vignura/CZ-02-BluetoothControl/1V00/HW/Images/CARBTF1.JPG

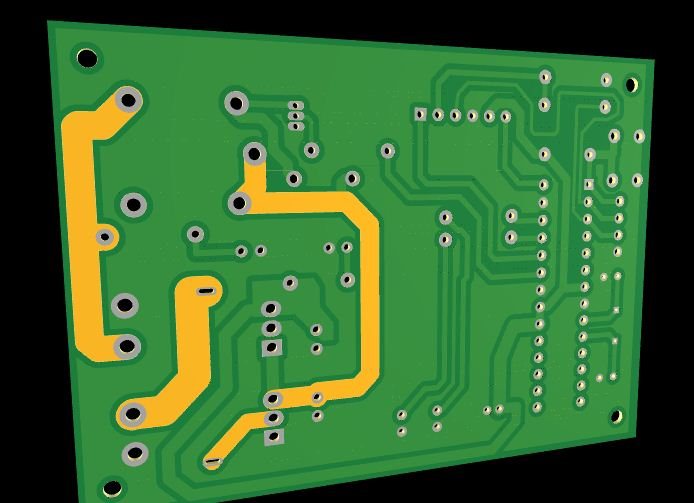
1V00/HW/Images/CARBTF1.JPG
