vignura/CZ-02-BluetoothControl/README.md

# CZ-02-BluetoothControl
bluetooth controller module

Note: This module uses Relay library that is available at below link.
https://github.com/vignura/Arduino/tree/master/libraries/Relay
