vignura/CZ-02-BluetoothControl/2V00/SW/Docs/PPT/Industrial Automation.odp

Bed Room Wiring

Switch 1

Fan

Switch 2

Night

Lamp

Tube

Light

Mains

(220V AC)

Switch 3

Switch 4

Terrace

Light

Switch 5

Light

Holder

Switch 6

3 Pin

Plug Point

## Slide 2

Start

Input 1

Input 1

Input 2

Input

Input 3

Input 1

Yes/No

Process

Yes/No

Yes/No

Yes/No

1.Input 1 = Limit sw 1(NO<COM) [High>Low] Relay 1 Off

2.Input 2 = Limit sw 1(NC<COM)[Low>High]Relay 2 On

3.Input 3 = Float sw 1(NC<COM)[High>Low]Relay 2 Off

4.Input 4 = Limit sw 2(NC<COM)[High>Low]Relay 2 Off

Stop

## Slide 3

Limit switch 1

-> GPIO X

Turn On Relay 1 if High

Turn Off Relay 1 if Low

## Slide 4

Bed Room Wiring

Type A

Switch 1

Fan

Switch 2

Night

Lamp

Relay Module

Tube

Light

Mains

(220V AC)

Switch 3

Switch 4

Terrace

Light

Switch 5

Light

Holder

Switch 6

3 Pin

Plug Point

## Slide 5

Bed Room Wiring

Type B

Switch 1

Fan

Switch 2

Night

Lamp

Relay Module

Tube

Light

Mains

(220V AC)

Bypass

Switch

Switch 3

Switch 4

Terrace

Light

Switch 5

Light

Holder

Switch 6

3 Pin

Plug Point

## Slide 6

## Slide 7

9.3 cm

2 cm

5.6 cm

## Slide 8

9.3 cm

2 cm

5.6 cm

## Slide 9

1.5 cm

9.2 cm

4.1 cm

## Slide 10

1.5 cm

9.2 cm

4.1 cm

## Slide 11

X

5.94 X

2.03 X

5.94 X

2.03 X
