vignura/CZ-02-BluetoothControl/2V00/SW/Docs/ICD/BluetoothController-ICD-1V01.odt

Interface Control Document

for

Bluetooth Controller Module

The Bluetooth Controller Module has the following commands,

1. Relay On with Time command
2. Relay Off command
3. Start Self Command

SNo | Command String | Description
1 | “RlyOn HH:MM:SS” | Turns on the Relay for time specified, (Timer) ON Time = ((HH * 3600) + (MM * 60) + SS) seconds
2 | “RlyOff” | Turns off the Relay
3 | “StTest” | Performs Self Test, in which, Usr_LED_1, Usr_LED_1 and Relay are turned on for 2 seconds and turned off.

Note:

Relay off command will turn relay off immedeately and stop any running timers.
