vignura/CZ-02-BluetoothControl/1V00/HW/BOM/BOM_CARBT_20181124124831.csv

ID | Name | Designator | Footprint | Quantity | Manufacturer Part | Manufacturer | Supplier | Supplier Part | Mounted
1 | ATMEGA328P-PU | U1 | DIP-28_300MIL | 1 | ATMEGA328P-PU | MICROCHIP | LCSC | C33901 | Yes
2 | L7805ABV | U2 | TO-220(TO-220-3) | 1 | L7805ABV | STMicroelectronics | LCSC | C16807 | Yes
3 | IRF9530NPBF | Q1 | TO-220(TO-220-3) | 1 | IRF9530NPBF | IR | LCSC | C2574 | Yes
4 | 1k | R1,R3 | AXIAL-0.3 | 2 | ? |  |  |  | Yes
5 | 49S | X1 | HC-49S | 1 | 49S DIP Crystal insulation film | YXC | LCSC | C35018 | Yes
6 | 22pF | C1,C3 | RAD-0.1 | 2 | 22pf/50V 10% | ReliaPro | LCSC | C9316 | Yes
7 | 2N3904 | Q2 | TO-92(TO-92-3) | 1 | 2N3904 | SEMTECH | LCSC | C118538 | Yes
8 | 1k | R2,R5,R7,R8 | AXIAL-0.4 | 4 | ? |  |  |  | Yes
9 | 1N4448 | D1 | DO-35 | 1 | 1N4448 | SEMTECH | LCSC | C54037 | Yes
10 | SRD-03VDC-SL-C | RELAY1 | RELAY-SL-SRD | 1 | SRD-03VDC-SL-C | SONGLE | LCSC | C24585 | Yes
11 | WJ2EDGVC-5.08-2P | P1,P3 | WJ2EDGVC-5.08-2P | 2 | WJ2EDGVC-5.08-2P | ReliaPro | LCSC | C8445 | Yes
12 | LEDOrange orange 3AO4UD | LED1,LED2,LED3,LED4 | LED-3MM | 4 | LEDOrange orange 3AO4UD | KENTO | LCSC | C62095 | Yes
13 | 47uF | C2,C4 | CAP-D6.3XF2.5 | 2 | Aluminum electrolytic capacitors47uF 63V 20% High frequency green gold | ValuePro | LCSC | C60712 | Yes
14 | 4.7k | R4 | AXIAL-0.4 | 1 | ? |  |  |  | Yes
15 | 10uF | C5 | CAP-D5.0XF2.0 | 1 | electrolytic capacitor 10UF 50V high frequency | ValuePro | LCSC | C78759 | Yes
16 | Header-Female-2.54_1x6 | P2 | HDR-6X1/2.54 | 1 | Female header 1*6p | BOOMELE | LCSC | C40877 | Yes
17 | 2.2K | R6 | AXIAL-0.4 | 1 | ? |  |  |  | Yes
18 | Header-Male-2.54_1x4 | H1 | 210S-1X4P | 1 | 210S-1*4P L=11.6MMGold-plated black | Ckmtw | LCSC | C124378 | Yes
19 | 5x20 BLX-Atype Fuse holder XC-7 | F1 | 5X20-BLX-A | 1 | 5x20 BLX-Atype Fuse holder XC-7 | XCFuse | LCSC | C3131 | Yes
20 | TS-1102-5016 | KEY1 | KEY-6.0*6.0-2 | 1 | TS-1102-5016 | SOFNG | LCSC | C111609 | Yes
