vignura/CZ-02-BluetoothControl/Plan/PCB-Production-Plan.ods

Sheet: Production
Component | Qty | Points / Component | Total points
Resistors | 7 | 2 | 14
Capacitor Disc | 3 | 2 | 6
Capacitor Electorlytic | 3 | 2 | 6
LED | 2 | 2 | 4
Crystal | 1 | 2 | 2
Diode | 2 | 2 | 4
Regulator (7805) | 1 | 3 | 3
Transistor | 1 | 3 | 3
Relay | 1 | 4 | 4
Fuse holder | 1 | 2 | 2
Reset button | 1 | 4 | 4
Screw Connector | 3 | 2 | 6
Female Bug strip 6 pin | 1 | 6 | 6
IC base | 1 | 28 | 28
Jumper | 3 | 2 | 6
 |  | Total points | 98
Time Per point | 25 | s
Total time per board | 2450 | s
 | 40.83 | mins
Total boards | 200
Total time | 490000 | s
 | 136.11 | Hrs
Hours per day | 5 | Hrs
Time in days | 27.222 | days
Persons | 2.5
Time in days | 10.8888

Sheet: Programming & Testing
No of Borads | 200 |  | Testing
 |  |  | Bluetooth App Setup time | 300 | s
 |  |  | Bluetooth Unpair and repair | 180 | s
Boot Loader Lodaing
Setup time | 1800 | s | Tests
Load Time | 30 | s | On test | 5
Total time | 6000 | s | Off | 5
 | 100 | mins | On 5 sec | 10
No of sessions | 4 |  | Self Test | 5
Session time | 25 | mins | Emergency Stop | 5
Seesion break | 5 | mins
 |  |  | Test Time / board | 210 | s
Total time | 150 | mins | Total time | 42300 | s
 |  |  |  | 11.75 | Hrs
Code Loading
Setup time | 5 | mins | No of persons | 1
Load Time | 30 | s | Hours / day | 3
Total time | 6000 | s | No of days | 3.9166666667 | days
 | 100 | mins
No of sessions | 4
Session time | 25 | mins
Seesion break | 5 | mins
 |  |  | Testing + Programming | 5 | days
Total time | 120.08 | mins
Time | 1 | day

Sheet: Plan
Task | Days | Comment
Production | 14 | 4 persons
Programming & Testing | 7 | 1 person
 | 21 | days
Efficency | 60 | %
Total time | 35 | days
Start of work | 27 Sep 2019
End of Work | 1 Nov 2019
Salary Details
No of persons | 4
Salary / day | 400
No of Days | 21
Total Salary | 33600 | Rs
Total Boards | 200
Salary / board | 168 | Rs
other overheads | 32
Amount / boards | 200 | Rs
