vignura/CZ-02-BluetoothControl/1V01/HW/Schematic/Schematic_CARBT2.0.pdf

## MC BASED BT CONTROL MODULE

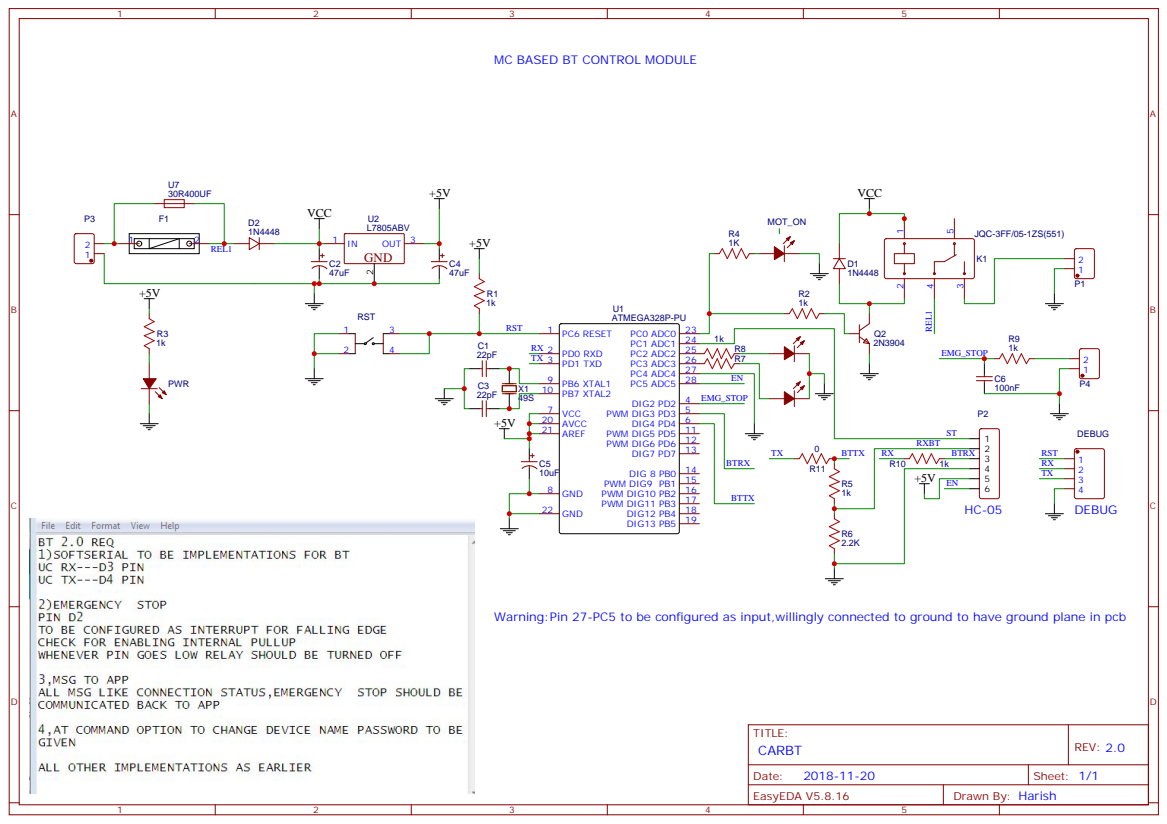
[picture p13: page 1]

Warning:Pin 27-PC5 to be configured as input,willingly connected to ground to have ground plane in pcb
