vignura/CZ-02-BluetoothControl/1V00/HW/Schematic/Schematic_CARBT_Sheet-1_20181124124802.pdf

+5V

## VCC

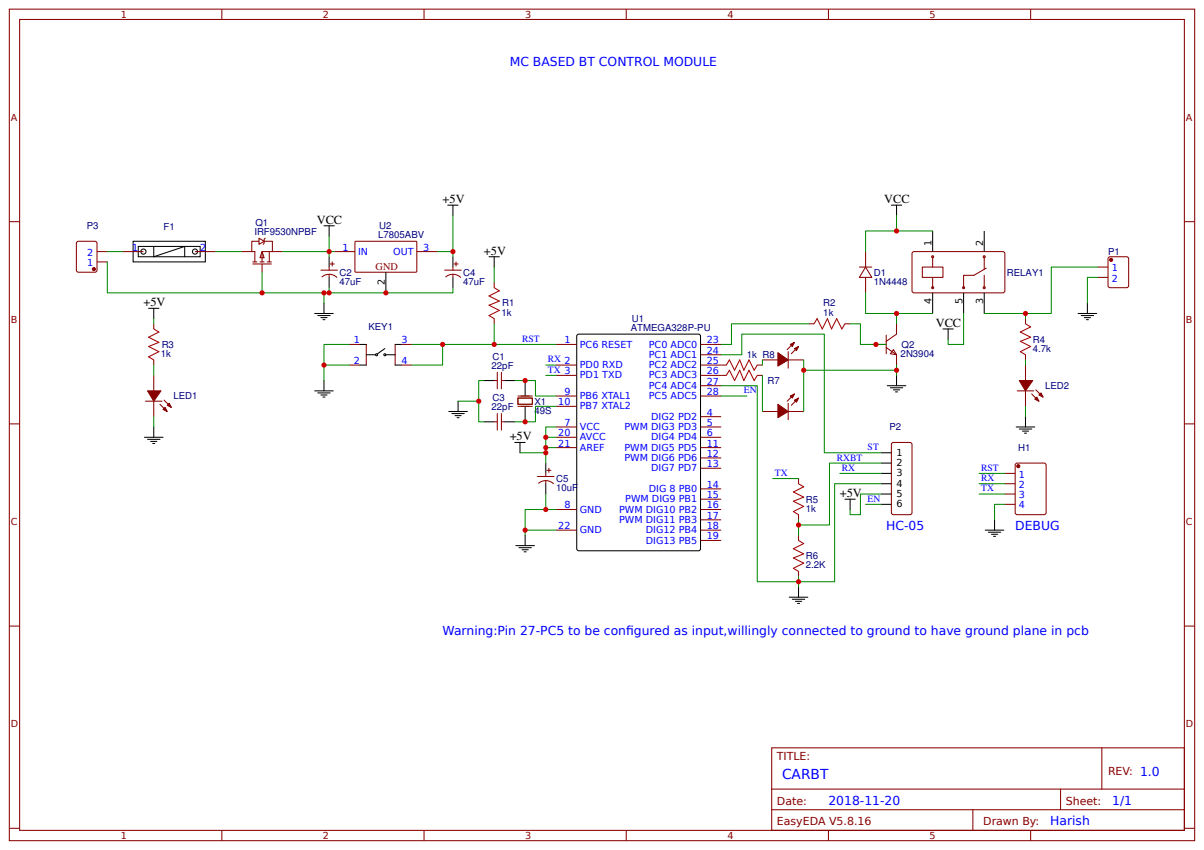
[picture p14: page 1]

MC BASED BT CONTROL MODULE

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
