vignura/CZ-02-BluetoothControl/(commit log)

2018-12-01 Initial Commit: Project Folder Creation
    [BOM_CARBT_20181124124831.csv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]
2018-12-04 Update CZ-02-BluetoothController.ino
    added printbytes()
2018-12-05 0v01 code
    [SerialPortSettings.ods]
2018-12-07 Using Relay library
2018-12-09 updaated after testing with board
2019-09-16 1V01 Started
    [BOM_CARBT_20181124124831.csv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]
2019-09-16 Added new Schematic
2019-09-16 Added Emergency stop interrupt
2019-09-17 Changed EMG_STOP Pin from 4 to 2
2019-09-21 Added Project Plan
    [PCB-Production-Plan.ods]
2019-10-02 removed Relay On command
    [PCB-Production-Plan.ods]
2019-11-24 Update: 1: Disabled Emg stop Interrupt; 2: Enabled Self Test at Init; 3: Added Response to Command Processor
    [Password-Gen.ods]
2020-12-16 added 2V00 for Home automation
    [Password-Gen.ods, SerialPortSettings.ods]
2020-12-18 changed BT TX pin form 4 to 2 and add relay number to BT response
2020-12-21 added checksum to store relay states
2021-01-08 added switch control along with bluetooth so that the relays can be turned on and off using both the switch and bluetooth
2021-01-13 Home automation tested with switch control
